programagor/uChronos/3D-board2.PNG

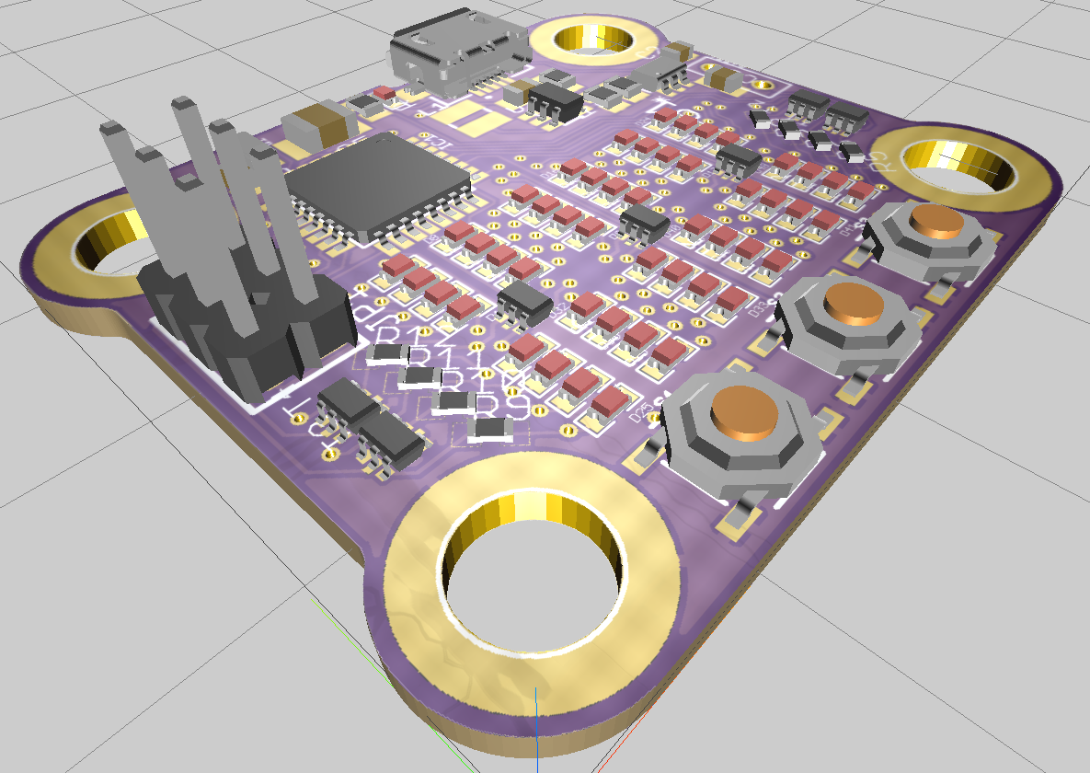
3D-board2.PNG
