programagor/uChronos/3D-board1.PNG

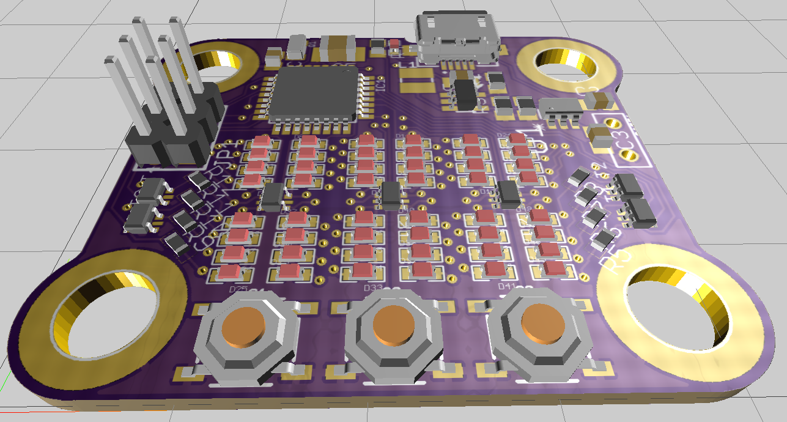
3D-board1.PNG
