programagor/uChronos/README.md

# uChronos
OSHW wristwatch which shows time in BCD
