programagor/uChronos/board-bottom.png

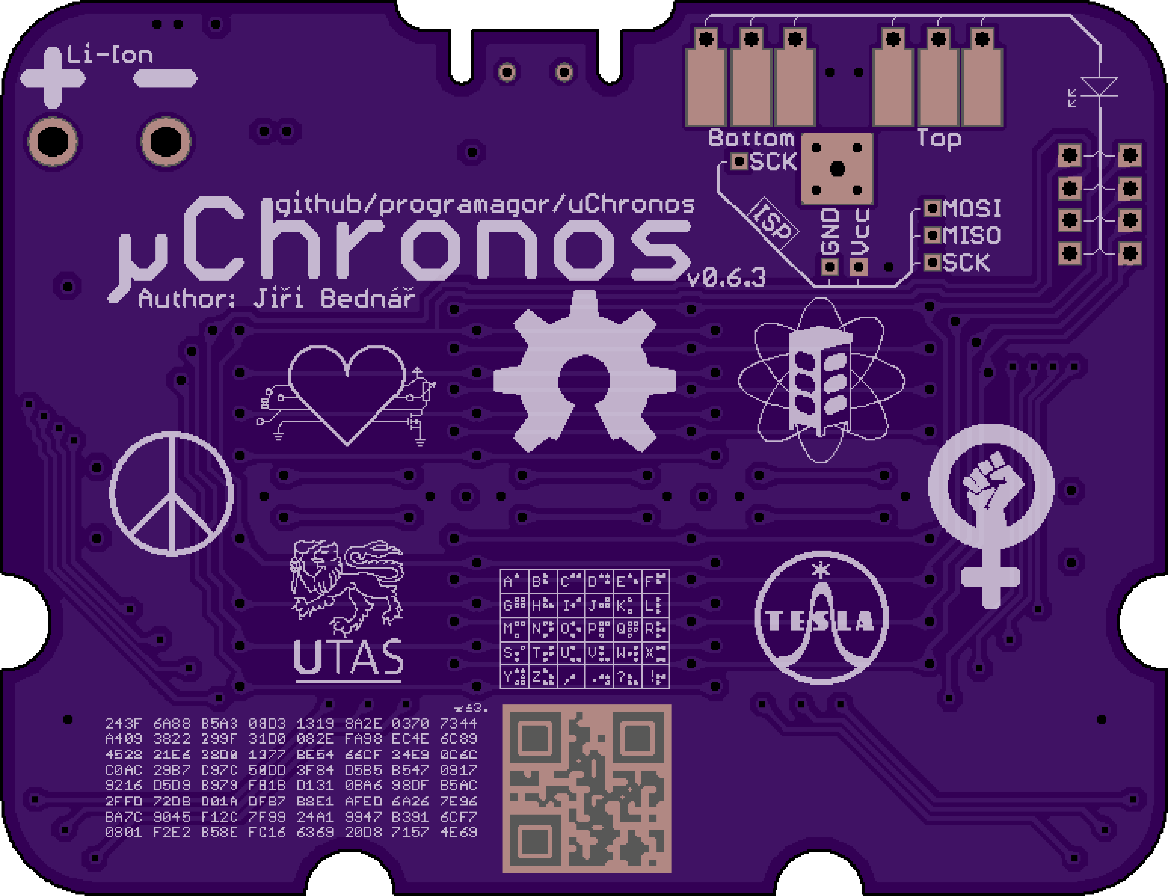
board-bottom.png
