programagor/uChronos/board-top.png

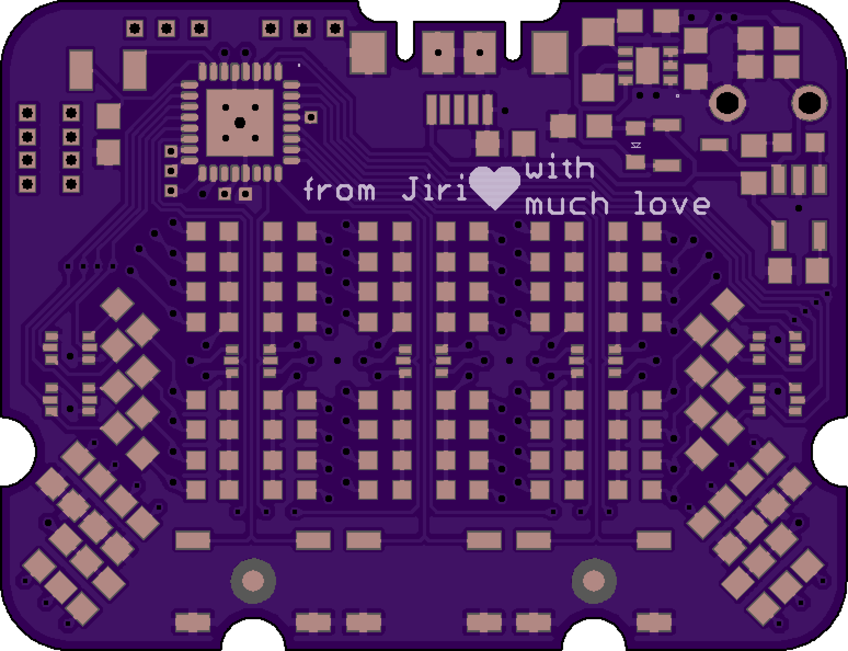
board-top.png
