programagor/uChronos/board.png

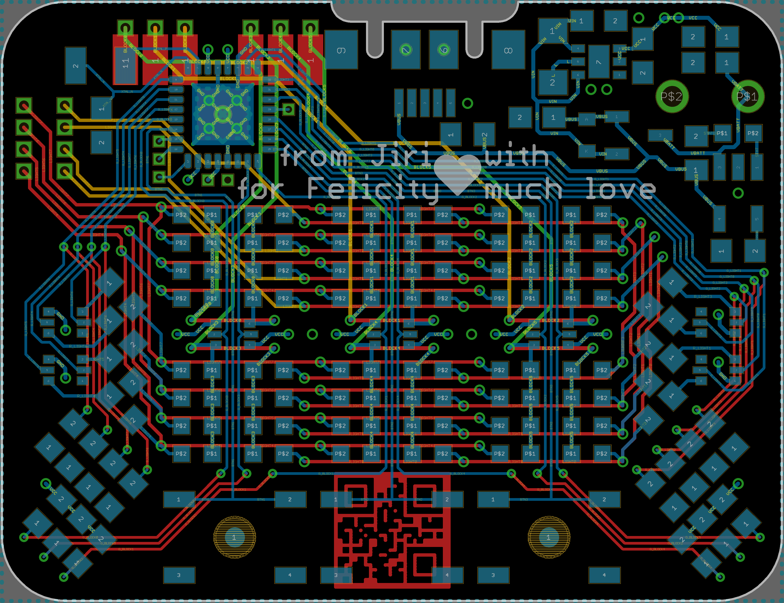
board.png
