programagor/uChronos/bin_watch.brd

## EAGLE design bin_watch.brd (2018-02-14)

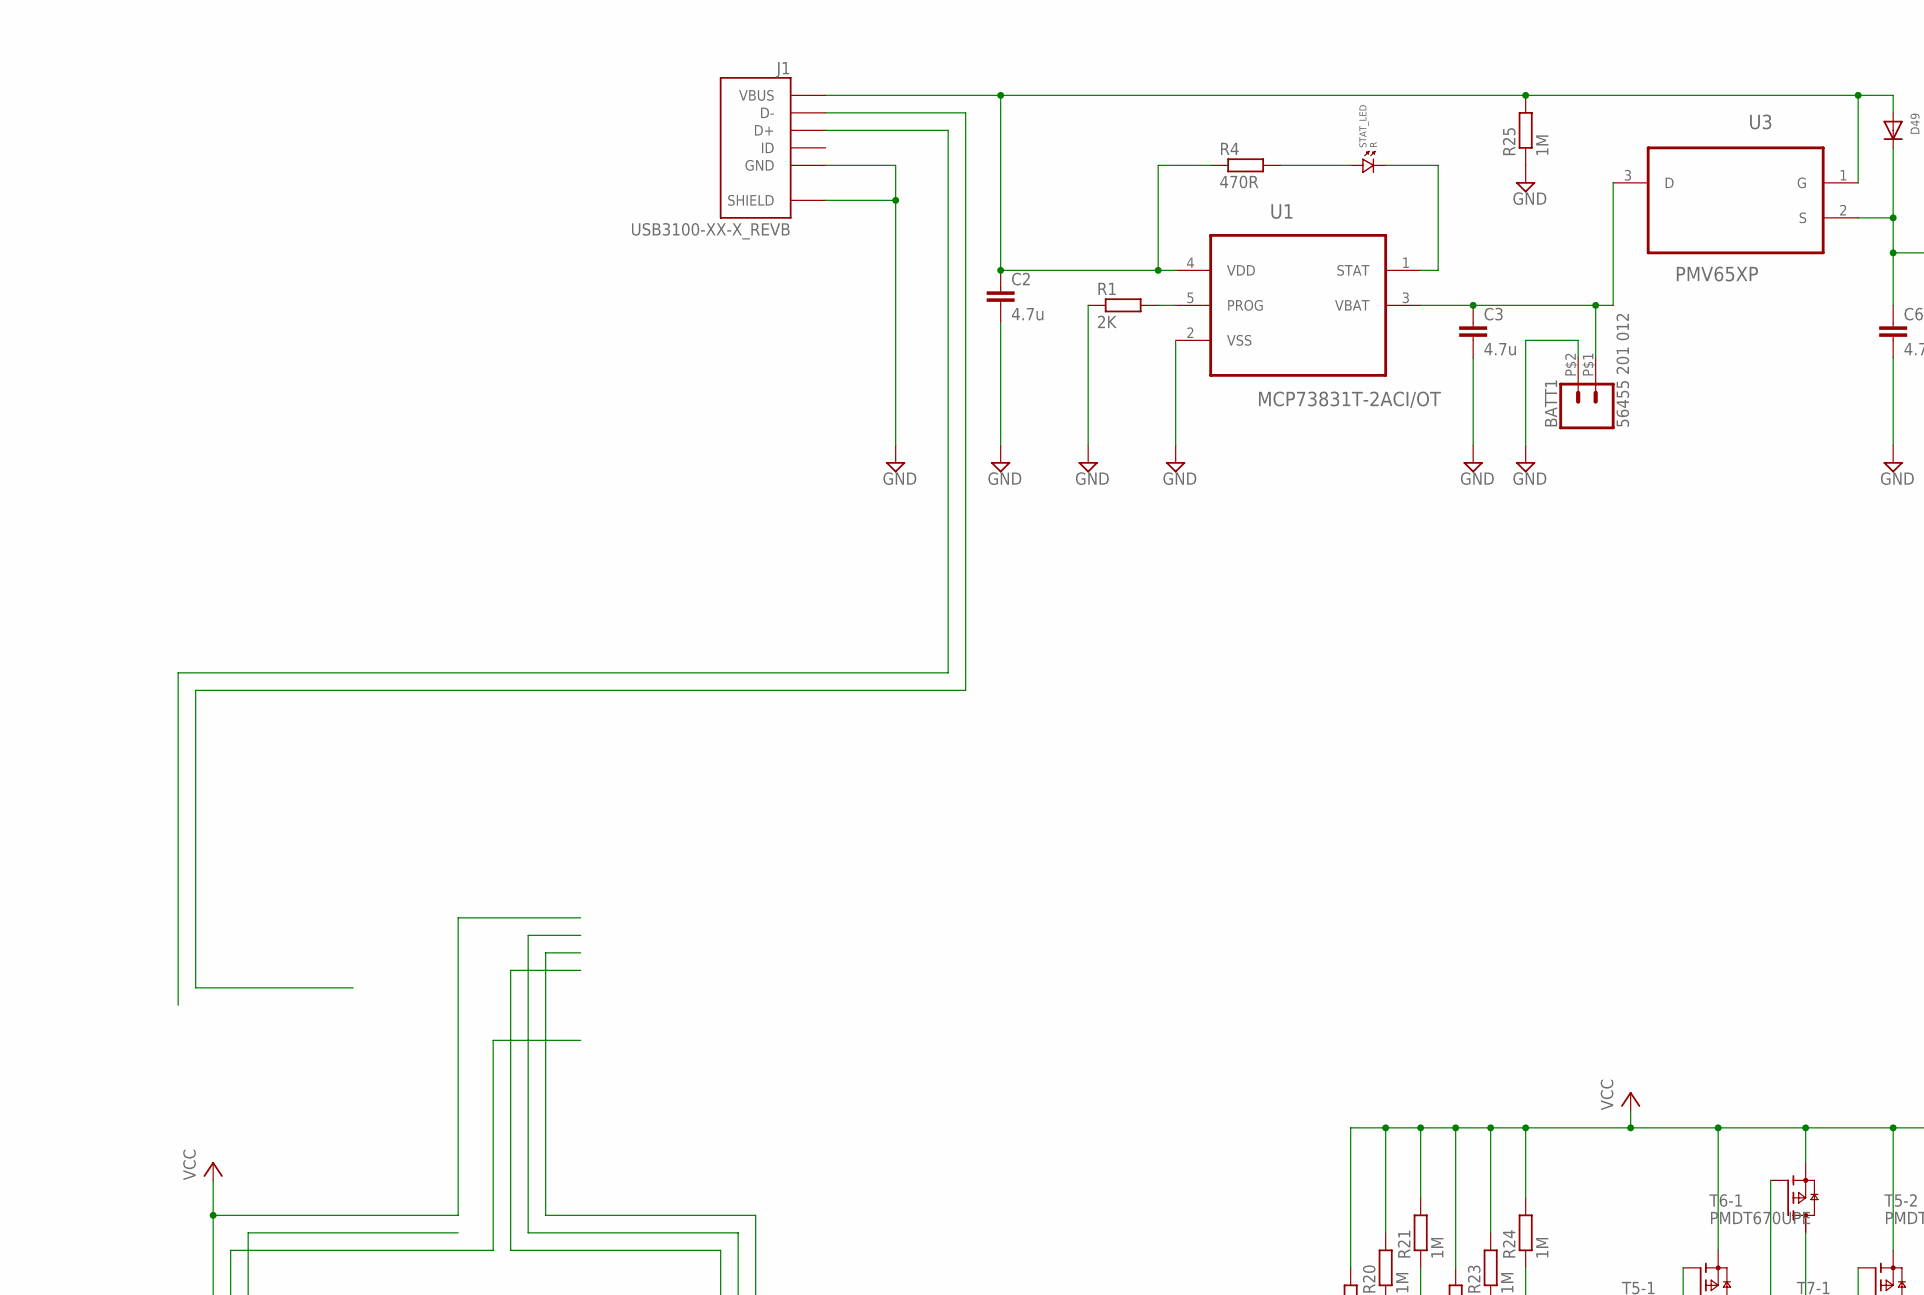
[picture p6: schematic bin_watch.sch, part in row 1, column 1]

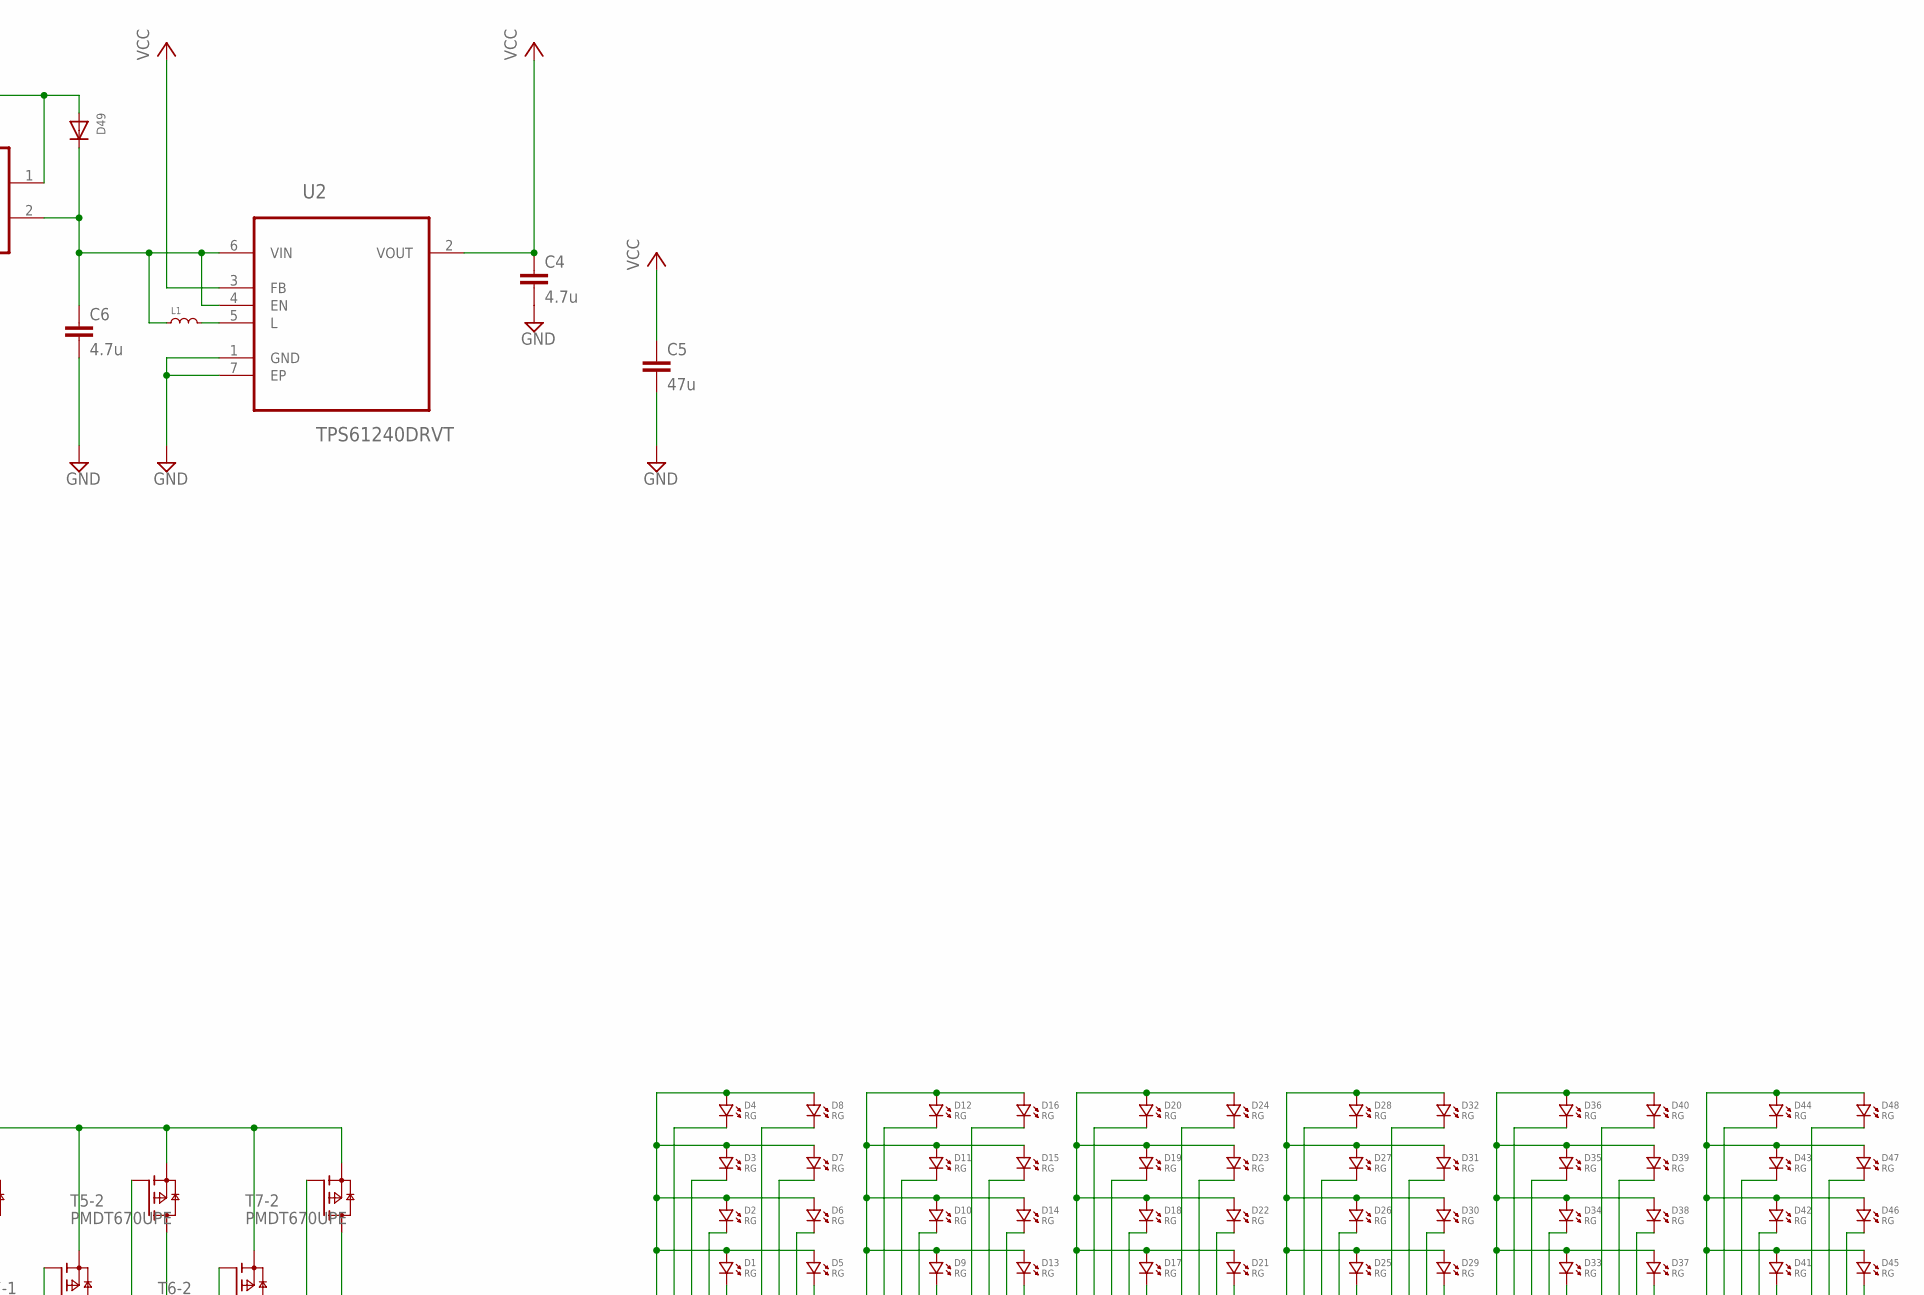
[picture p7: schematic bin_watch.sch, part in row 1, column 2]

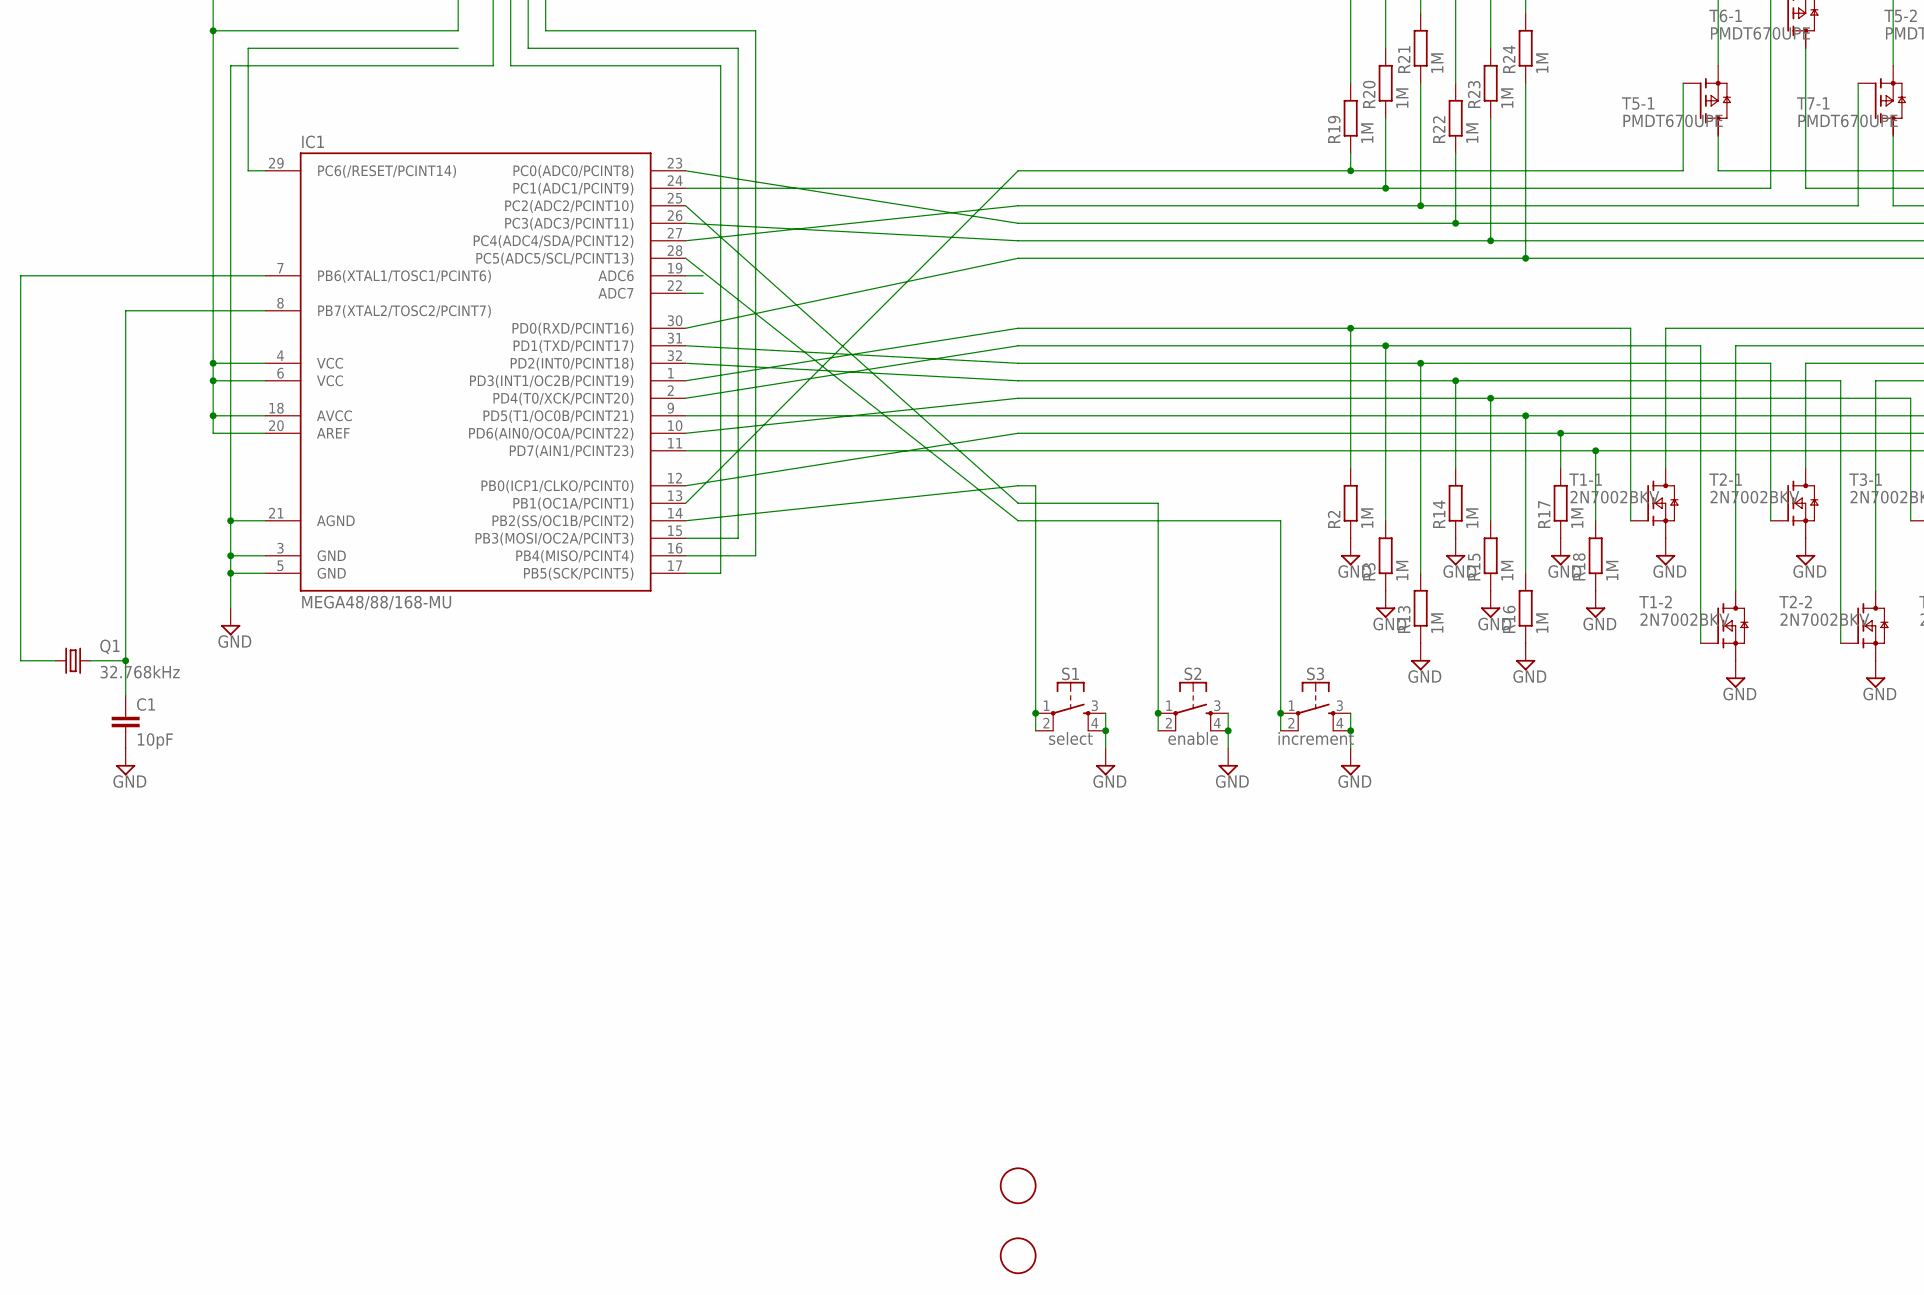
[picture p8: schematic bin_watch.sch, part in row 2, column 1]

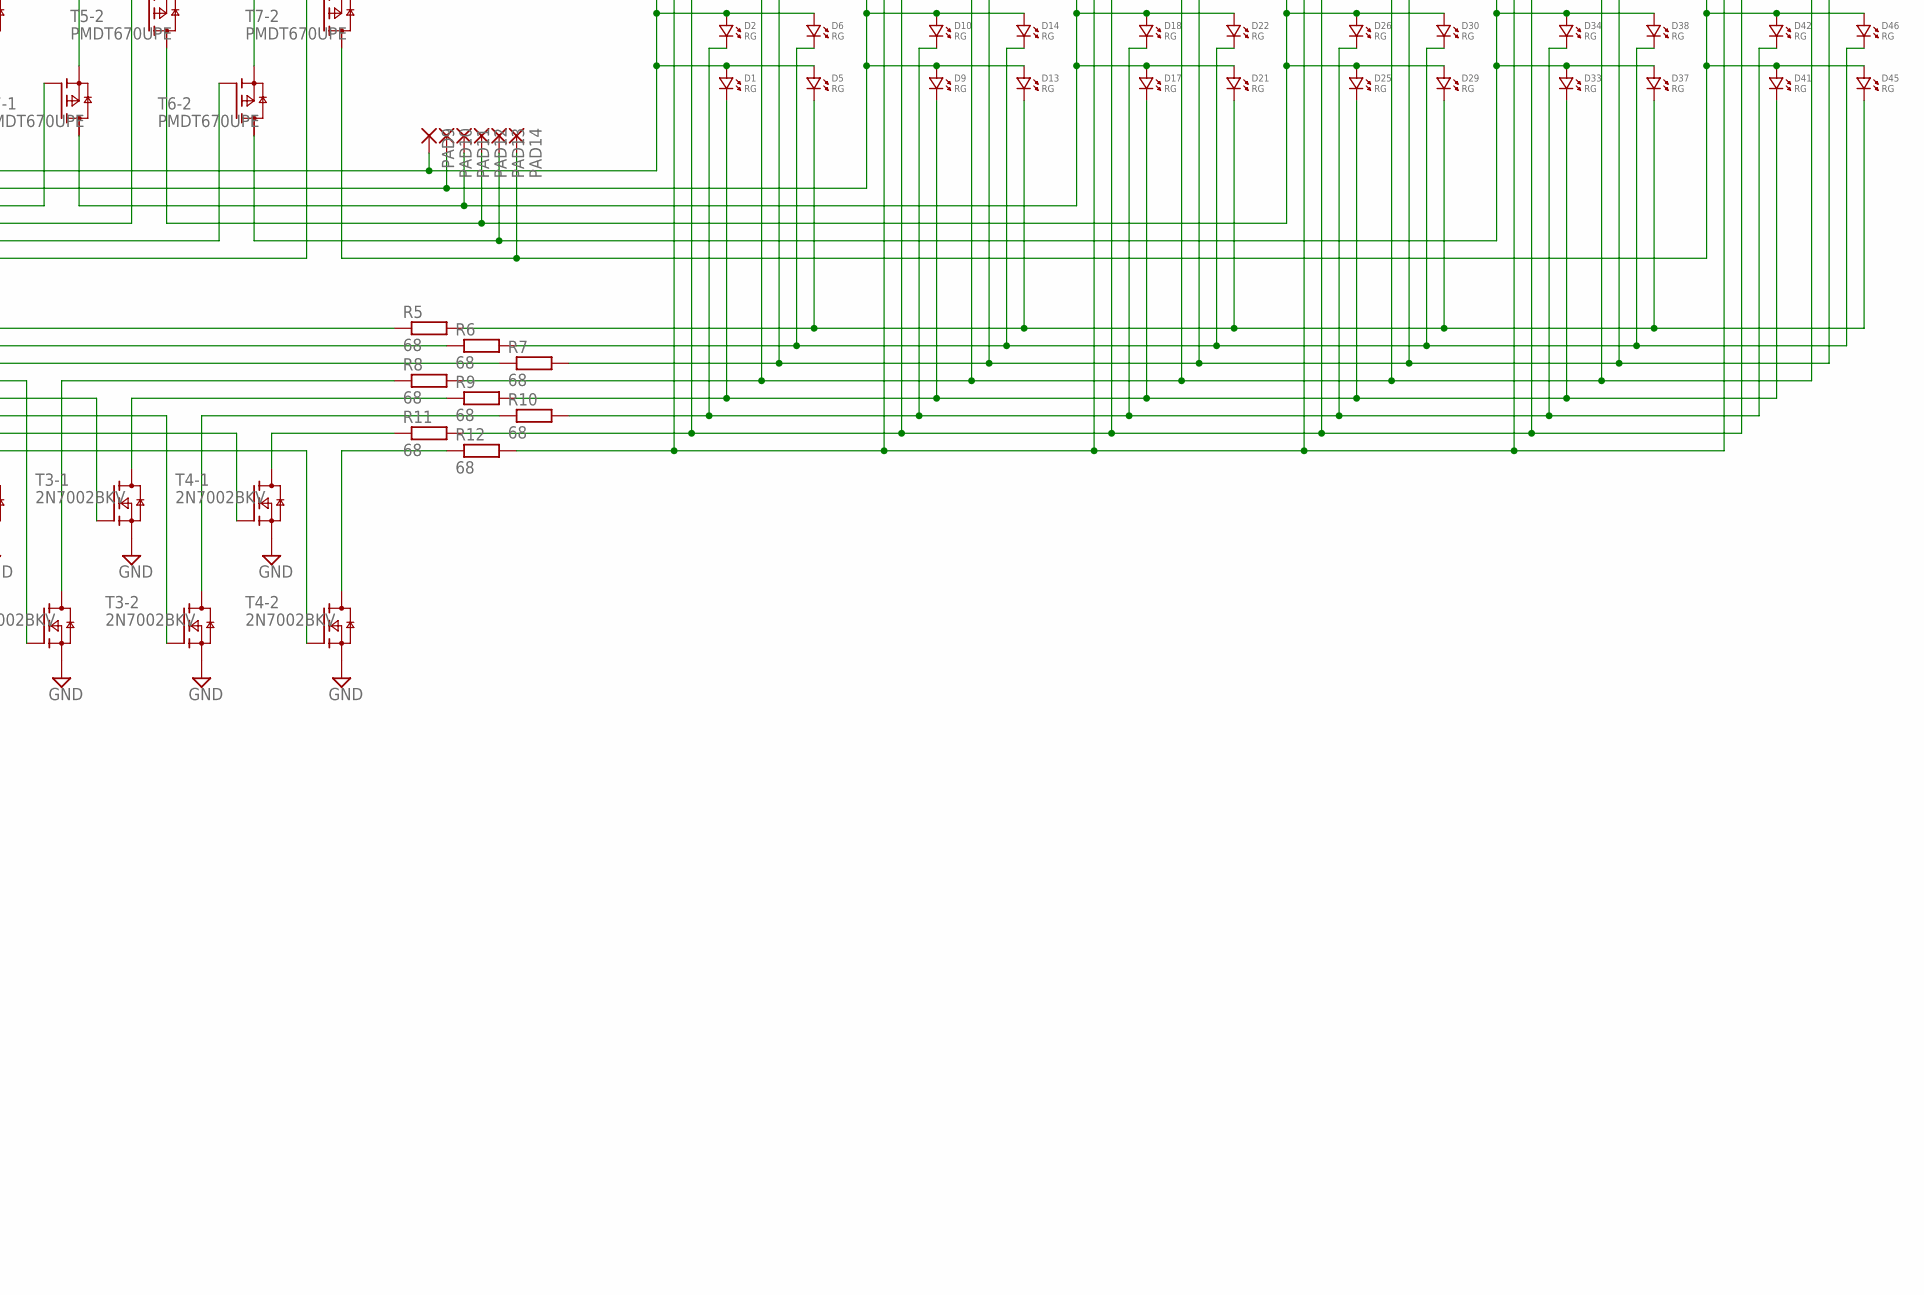
[picture p9: schematic bin_watch.sch, part in row 2, column 2]

Parts:
BATT1: 56455 201 012; 1X02_BIG
C1: 10pF; C0603
C2, C3, C4, C6: 4.7u; C0603
C5: 47u; C0603
D1, D2, D3, D4, D5, D6, D7, D8, D9, D10, D11, D12, D13, D14, D15, D16, D17, D18, D19, D20, D21, D22, D23, D24, D25, D26, D27, D28, D29, D30, D31, D32, D33, D34, D35, D36, D37, D38, D39, D40, D41, D42, D43, D44, D45, D46, D47, D48: RG; 0603.LED
D49: DIODESOD-523; SOD-523
IC1: MEGA48/88/168-MU; MLF32
J1: USB3100-XX-X_REVB; GCT_USB3100-XX-X_REVB
L1: RF-INDUCTOR.0805; 0805
PAD9, PAD10, PAD11, PAD12, PAD13, PAD14: SMD2; SMD1,27-2,54
Q1: 32.768kHz; 3.2X1.5
R1: 2K; R0603
R2, R3, R13, R14, R15, R16, R17, R18, R19, R20, R21, R22, R23, R24, R25: 1M; R0603
R4: 470R; R0603
R5, R6, R7, R8, R9, R10, R11, R12: 68; R0603
S1: select; TACTILE_SWITCH_SMD_5.2MM
S2: enable; TACTILE_SWITCH_SMD_5.2MM
S3: increment; TACTILE_SWITCH_SMD_5.2MM
STAT_LED: R; 0603.LED
T1, T2, T3, T4: 2N7002BKV; SOT666
T5, T6, T7: PMDT670UPE; SOT666
U1: MCP73831T-2ACI/OT; SOT95P280X145-5N
U2: TPS61240DRVT; SON65P200X200X80-7N
U3: PMV65XP; SOT95P230X110-3N
U$1, U$2: FIDUCIAL; FIDUCIAL_1MM

Connections:
ADC6: IC1.19 (ADC6)
ADC7: IC1.22 (ADC7)
BLOCK0: D1.P$1 (1), D2.P$1 (1), D3.P$1 (1), D4.P$1 (1), D5.P$1 (1), D6.P$1 (1), D7.P$1 (1), D8.P$1 (1), PAD9.1, T5.6 (D)
BLOCK1: D9.P$1 (1), D10.P$1 (1), D11.P$1 (1), D12.P$1 (1), D13.P$1 (1), D14.P$1 (1), D15.P$1 (1), D16.P$1 (1), PAD10.1, T6.6 (D)
BLOCK2: D17.P$1 (1), D18.P$1 (1), D19.P$1 (1), D20.P$1 (1), D21.P$1 (1), D22.P$1 (1), D23.P$1 (1), D24.P$1 (1), PAD11.1, T7.6 (D)
BLOCK3: D25.P$1 (1), D26.P$1 (1), D27.P$1 (1), D28.P$1 (1), D29.P$1 (1), D30.P$1 (1), D31.P$1 (1), D32.P$1 (1), PAD12.1, T5.3 (D)
BLOCK4: D33.P$1 (1), D34.P$1 (1), D35.P$1 (1), D36.P$1 (1), D37.P$1 (1), D38.P$1 (1), D39.P$1 (1), D40.P$1 (1), PAD13.1, T6.3 (D)
BLOCK5: D41.P$1 (1), D42.P$1 (1), D43.P$1 (1), D44.P$1 (1), D45.P$1 (1), D46.P$1 (1), D47.P$1 (1), D48.P$1 (1), PAD14.1, T7.3 (D)
BTN1: IC1.14 (PB2(SS/OC1B/PCINT2)), S1.1, S1.2
BTN2: IC1.25 (PC2(ADC2/PCINT10)), S2.1, S2.2
BTN3: IC1.28 (PC5(ADC5/SCL/PCINT13)), S3.1, S3.2
D_N: J1.2 (D-)
D_P: J1.3 (D+)
GND: BATT1.P$2 (2), C1.2, C2.2, C3.2, C4.2, C5.2, C6.2, IC1.3 (GND), IC1.5 (GND), IC1.21 (AGND), J1.5 (GND), J1.6 (SHIELD), J1.7 (SHIELD), J1.8 (SHIELD), J1.9 (SHIELD), R1.1, R2.1, R3.1, R13.1, R14.1, R15.1, R16.1, R17.1, R18.1, R25.1, S1.3, S1.4, S2.3, S2.4, S3.3, S3.4, T1.1 (S), T1.4 (S), T2.1 (S), T2.4 (S), T3.1 (S), T3.4 (S), T4.1 (S), T4.4 (S), U1.2 (VSS), U2.1 (GND), U2.7 (EP)
G_BLOCK0: IC1.13 (PB1(OC1A/PCINT1)), R19.1, T5.2 (G)
G_BLOCK1: IC1.24 (PC1(ADC1/PCINT9)), R20.1, T6.2 (G)
G_BLOCK2: IC1.27 (PC4(ADC4/SDA/PCINT12)), R21.1, T7.2 (G)
G_BLOCK3: IC1.23 (PC0(ADC0/PCINT8)), R22.1, T5.5 (G)
G_BLOCK4: IC1.26 (PC3(ADC3/PCINT11)), R23.1, T6.5 (G)
G_BLOCK5: IC1.30 (PD0(RXD/PCINT16)), R24.1, T7.5 (G)
G_LIGHT0: IC1.1 (PD3(INT1/OC2B/PCINT19)), R2.2, T1.2 (G)
G_LIGHT1: IC1.2 (PD4(T0/XCK/PCINT20)), R3.2, T1.5 (G)
G_LIGHT2: IC1.31 (PD1(TXD/PCINT17)), R13.2, T2.2 (G)
G_LIGHT3: IC1.32 (PD2(INT0/PCINT18)), R14.2, T2.5 (G)
G_LIGHT4: IC1.10 (PD6(AIN0/OC0A/PCINT22)), R15.2, T3.2 (G)
G_LIGHT5: IC1.9 (PD5(T1/OC0B/PCINT21)), R16.2, T3.5 (G)
G_LIGHT6: IC1.12 (PB0(ICP1/CLKO/PCINT0)), R17.2, T4.2 (G)
G_LIGHT7: IC1.11 (PD7(AIN1/PCINT23)), R18.2, T4.5 (G)
L: L1.2, U2.5 (L)
LIGHT0: D5.P$2 (2), D13.P$2 (2), D21.P$2 (2), D29.P$2 (2), D37.P$2 (2), D45.P$2 (2), R5.2
LIGHT1: D6.P$2 (2), D14.P$2 (2), D22.P$2 (2), D30.P$2 (2), D38.P$2 (2), D46.P$2 (2), R6.2
LIGHT2: D7.P$2 (2), D15.P$2 (2), D23.P$2 (2), D31.P$2 (2), D39.P$2 (2), D47.P$2 (2), R7.2
LIGHT3: D8.P$2 (2), D16.P$2 (2), D24.P$2 (2), D32.P$2 (2), D40.P$2 (2), D48.P$2 (2), R8.2
LIGHT4: D1.P$2 (2), D9.P$2 (2), D17.P$2 (2), D25.P$2 (2), D33.P$2 (2), D41.P$2 (2), R9.2
LIGHT5: D2.P$2 (2), D10.P$2 (2), D18.P$2 (2), D26.P$2 (2), D34.P$2 (2), D42.P$2 (2), R10.2
LIGHT6: D3.P$2 (2), D11.P$2 (2), D19.P$2 (2), D27.P$2 (2), D35.P$2 (2), D43.P$2 (2), R11.2
LIGHT7: D4.P$2 (2), D12.P$2 (2), D20.P$2 (2), D28.P$2 (2), D36.P$2 (2), D44.P$2 (2), R12.2
MISO: IC1.16 (PB4(MISO/PCINT4))
MOSI: IC1.15 (PB3(MOSI/OC2A/PCINT3))
PROG: R1.2, U1.5 (PROG)
RST: IC1.29 (PC6(/RESET/PCINT14))
R_LIGHT0: R5.1, T1.6 (D)
R_LIGHT1: R6.1, T1.3 (D)
R_LIGHT2: R7.1, T2.6 (D)
R_LIGHT3: R8.1, T2.3 (D)
R_LIGHT4: R9.1, T3.6 (D)
R_LIGHT5: R10.1, T3.3 (D)
R_LIGHT6: R11.1, T4.6 (D)
R_LIGHT7: R12.1, T4.3 (D)
SCK: IC1.17 (PB5(SCK/PCINT5))
STAT: STAT_LED.P$2 (2), U1.1 (STAT)
STAT_R: R4.2, STAT_LED.P$1 (1)
VBATT: BATT1.P$1 (1), C3.1, U1.3 (VBAT), U3.3 (D)
VBUS: C2.1, D49.A, J1.1 (VBUS), R4.1, R25.2, U1.4 (VDD), U3.1 (G)
VCC: C4.1, C5.1, IC1.4 (VCC), IC1.6 (VCC), IC1.18 (AVCC), IC1.20 (AREF), R19.2, R20.2, R21.2, R22.2, R23.2, R24.2, T5.1 (S), T5.4 (S), T6.1 (S), T6.4 (S), T7.1 (S), T7.4 (S), U2.2 (VOUT), U2.3 (FB)
VIN: C6.1, D49.K (C), L1.1, U2.4 (EN), U2.6 (VIN), U3.2 (S)
XTAL_N: C1.1, IC1.8 (PB7(XTAL2/TOSC2/PCINT7)), Q1.2
XTAL_P: IC1.7 (PB6(XTAL1/TOSC1/PCINT6)), Q1.1

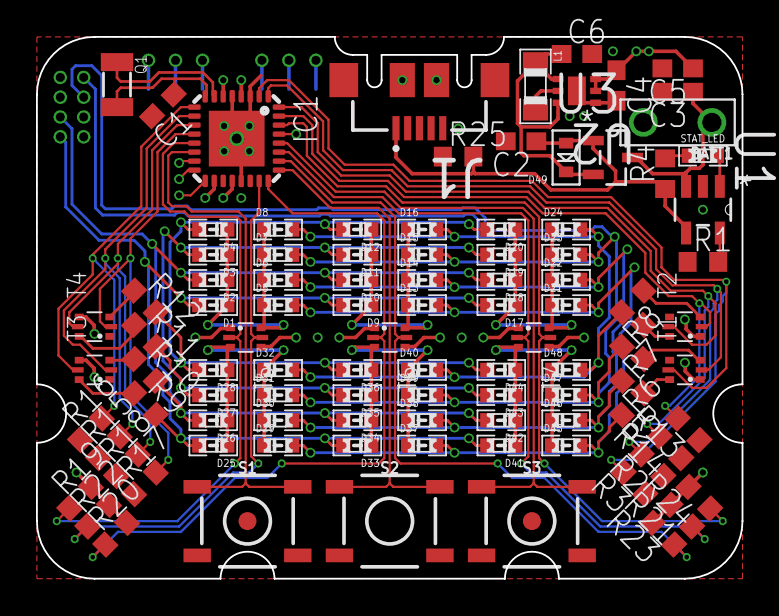
[picture p10: board bin_watch.brd from above]

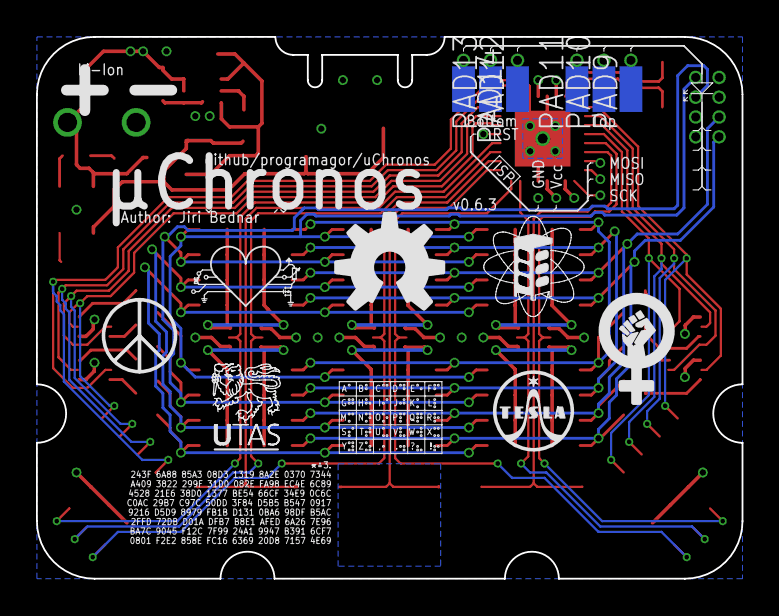
[picture p11: board bin_watch.brd from below]

Board: 4 copper layers, 39.2 x 30.1 mm, 107 parts (6 on the bottom side), 50 nets.
