programagor/uChronos/(commit log)

2017-08-15 Initial commit
    First version of the schematics and the board
    [bin_watch.brd, bin_watch.sch]
2017-08-15 Route cleanup
    I ditched the auto-routed traces, and hand-routed everything. This should be much easier to work with.
    [bin_watch.brd, bin_watch.sch]
2017-08-15 Switched to Li-ion
    The button cell i not up to the task, so we need a Li-ion battery.
    [bin_watch.brd, bin_watch.sch]
2017-08-15 Switched to switching supply
    The linear regulator is not very efficient, swapping it for a buck converter.
    [bin_watch.brd, bin_watch.sch]
2017-08-15 Added I limiting resistors
    Relying on the FETs to limit the current to diodes is not very safe, so added resistors to do that. It's a tight squeeze, but it fits.
    [bin_watch.brd, bin_watch.sch]
2017-08-15 Added board preview
    Image showing all relevant layers
2017-08-16 Added notes
    To keep track of the design decisions that were made
2017-08-16 Added 3D views of the board
2017-08-16 Added BOM
    Bill of materials, format:
    Part, manufacturer code, element14 order code, amount
    [BOM.csv]
2017-08-16 Added potentiometer
    This is to enable small adjustments to the system voltage around 3.5 V
    [bin_watch.brd, bin_watch.sch]
2017-08-16 Updated BOM
    Now all components are 0603
    [BOM.csv]
2017-08-16 Little tweaks
    Ipdated component names, positions, and version label.
    [bin_watch.brd, bin_watch.sch]
2017-08-21 Small tweaks to traces
    [bin_watch.brd]
2017-08-23 Small tweaks
    Fixed non-n45° traces.
    TODO: mirror the QR code
    [bin_watch.brd]
2017-08-23 v0.5 - Incremented displayed number
    The PCB now shows v0.5 as the version.
    [bin_watch.brd]
2017-08-23 Mirrored the QR code
    Now the QR code on the bottom side has the right orientation.
    [bin_watch.brd]
2017-08-26 More tweaking
    Fixed some angles and spacing, improved groundfill slightly. Fixed the QR code (inverted, mirrored).
    [bin_watch.brd]
2017-08-27 Added Gerber files, small tweaks to the board
    Gerbers optimised for PCBway, but probably acceptable by most other fabs.
    The board now has little holes around the big mounting holes, ostensibly to increase the durability/redundancy of the inner plating, but the real reason is that it looks cool.
    [bin_watch.brd]
2017-09-05 Added fiducial marks
    Some minor adjustments to the traces, and added fiducial marks for the board and for the chip.
    [bin_watch.brd, bin_watch.sch]
2017-09-17 Fixed silkscreen width issue
    MetaLab logo now renders correctly at 500 DPI
    [bin_watch.brd]
2017-09-17 Changed power supply to 5V
    Replaced the Buck converter with a Boost converter. Saved some space.
    [bin_watch.brd, bin_watch.sch]
2017-09-17 Removed mounting holes
    Saved a lot more space
    [bin_watch.brd, bin_watch.sch]
2017-09-17 Added charger isolation
    When the battery is being charged, the Boost converter is powered directly from USB rather than through the charger.
    [bin_watch.brd, bin_watch.sch]
2017-09-17 4-layer design
    Now using ground and power plane
    [bin_watch.brd, bin_watch.sch]
2017-09-18 QFN
    ATmega328 now a QFN-32
    TODO: place components, route
    [bin_watch.brd, bin_watch.sch]
2017-09-18 Replaced AVR ISP with smaller pads
    [bin_watch.brd, bin_watch.sch]
2017-09-19 IOs rewired
    Changed the IO wiring to reduce the number of vias.
    TODO: Power supply routing
    [bin_watch.brd, bin_watch.sch]
2017-09-19 Board shrunk
    Sized down version
    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
    [bin_watch.brd, bin_watch.sch]
2017-09-19 Fully routed
    [bin_watch.brd]
2017-09-19 Added pull resistors to N-gates
    Thois way, when the gates are not driven, they'll default to open-circuit.
    [bin_watch.brd, bin_watch.sch]
2017-09-19 Revert "Added pull resistors to N-gates"
    This reverts commit 9868d69179800805ca64c73f808847093c2a5451.
    [bin_watch.brd, bin_watch.sch]
2017-09-19 Added pull resistors to N-channels
    This way, when the gates are not driven, they default to OFF
    [bin_watch.brd, bin_watch.sch]
2017-09-19 Pull resistors for N-channels routed
    [bin_watch.brd, bin_watch.sch]
2017-09-20 Added solder pads for blocks
    [bin_watch.brd, bin_watch.sch]
2017-09-23 Started routing wirepads to drivers
    So that the board can be used as a driver for external loads
    [bin_watch.brd, bin_watch.sch]
2017-09-28 Mass commit
    This is a mess...
    Added a new firmware attempt, this time in C language.
    Several changes to the board
    A a pull resistor for the gate of the power transistor
    Stuff I forgot...
    [bin_watch.brd, bin_watch.sch]
2017-09-29 Added support for buttons
    And a lot of other things
2017-10-02 Introduced the state machine
    Now a lot of functions are available, and a mechanism for general state transitions with button presses (down and up event).
    Function pointers are cool!
2017-10-14 Everything fully routed
    [bin_watch.brd, bin_watch.sch]
2017-10-15 Updated board preview
2017-10-16 Added mounting notches
    [bin_watch.brd]
2017-10-16 Gerbers updated
    [bin_watch.brd]
2017-10-16 Fixed bottom silkscreen in Gerbers
2017-10-16 Fixed errors in bottom silkscreen
    Now it's presentable
    [bin_watch.brd]
2017-10-16 Added Braille Alphabet to bottom silkscreen
    [bin_watch.brd]
2017-10-16 Added TESLA logo
    [bin_watch.brd]
2017-10-19 Small adjustments
    Silkscreen, spacing, and other little things
    [bin_watch.brd]
2017-10-22 Added gerber with teardrops on vias
    [bin_watch.brd]
2017-10-24 Routing optimisation
    Some splits removed frominternal groundplane
    [bin_watch.brd]
2017-10-24 Added groundpad
    The library file was missing soldermask for the groundpad, so one was added manually.
    [bin_watch.brd]
2017-10-25 Fixed broken build of FW
    Bad naming convention in the state machine
    [state_machine.c]
2017-10-26 Added UTAS logo to bottom silkscreen (WIP)
    Lion head needs to be finished
    [bin_watch.brd]
2017-10-26 More work on the lion (WIP)
    [bin_watch.brd]
2017-10-26 Even more work on the lion (WIP)
    Now only need to do the mane
    [bin_watch.brd]
2017-10-26 UTAS logo finished
    [bin_watch.brd]
2017-10-28 Small silkscreen changes
    [bin_watch.brd]
2017-10-30 More stuff added to silkscreen
    Feminism and Hippie logo
    [bin_watch.brd]
2017-10-30 Gerber files updated to current board version
2017-11-01 Fixed bad paste layer
    Added 1mil-2.5mil gap between pad edge and paste
    [bin_watch.brd]
2017-11-06 Added board images
    Rendered by OSHpark
2017-11-09 Straightend some tiny kinks on a fw lines
    [bin_watch.brd]
2017-11-16 Made the external connctor smaller
    [bin_watch.brd, bin_watch.sch]
2017-11-17 Crystal moved out of the way
    [bin_watch.brd]
2017-11-19 Moved connector up
    [bin_watch.brd]
2017-11-21 Synchronous operation calibrated
2017-11-25 Moved crystal
    TODO: Pick existing uC for ISP
    [bin_watch.brd, bin_watch.sch]
2017-11-28 Fixed undocumented clearance violations
    [bin_watch.brd, bin_watch.sch]
2017-12-01 Fixed the state machine's init_text function
    [main.c, snake.c, state_machine.c, state_machine.h, time_utils.c]
2017-12-03 Fixed some modulo errors (edge cases)
    [main.c, snake.c]
2018-02-14 Changed fonts to Vector
    [bin_watch.brd]
